IntegralIndustries/hqdd1/hardware/hqdd_1.step

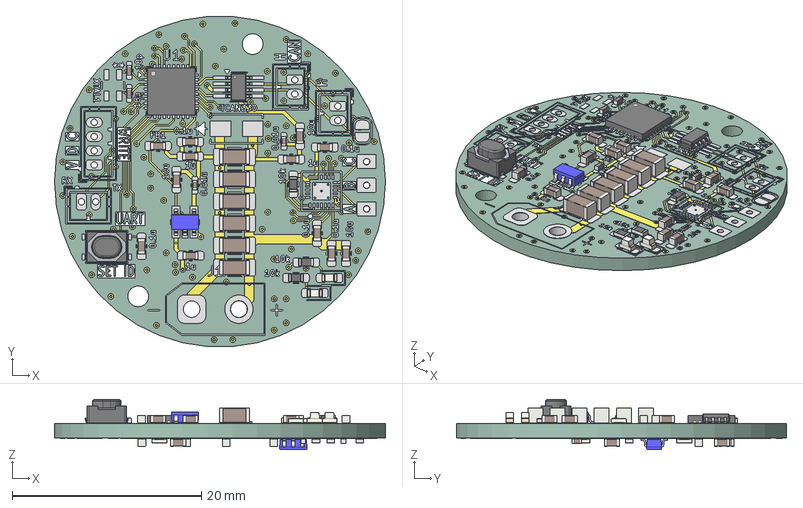
[picture p1: CAD file, 2026-11-10]
hardware/hqdd_1.step
35.0 x 34.9 x 5.33 mm
SMV x 2
C_1206_3216Metric x 6
QFN-32-1EP_5x5mm_Pitch0.5mm
R_0603_1608Metric x 8
C_0402_1005Metric x 6
C_0603_1608Metric x 17
TSOT-23-8
SW_SPST_PTS810
LED_0603_1608Metric x 2
hqdd_1_copper
hqdd_1_pad
hqdd_1_via
hqdd_1_silkscreen x 2
hqdd_1_PCB
